HexabitzPlatform/H05R1x-Hardware/README.md

# H05R1x-Hardware

Hexabitz USB-C PD LiPo charger Module Hardware Design.

Design this module using the STM32G0B1CEU6 MCU and BQ25792 + MAX17201G+T ICs. Use the H05R0 module design as a reference.

This design must use two hexagons with a 4-layer PCB stack-up.
