HexabitzPlatform/H05R1x-Hardware/Released/BOM/H05R1_BOM.xlsx

Line # | Name | Description | Designator | Revision ID | Revision State | Revision Status | Quantity | Manufacturer 1 | Manufacturer Part Number 1 | Manufacturer Lifecycle 1 | Supplier 1 | Supplier Part Number 1 | Supplier Unit Price 1 | Supplier Subtotal 1
 | CL10B104KA8NNNC | Ceramic Capacitor, Multilayer, Ceramic, 25V, 10% +Tol, 10% -Tol, X7R, +-15% TC, 100nF, Surface Mount, 0603 inch | C1, C3, C5 |  | Not managed |  | 3
 | CL21X475KAQNNNE | Ceramic Capacitor, Multilayer, Ceramic, 25V, 10% +Tol, 10% -Tol, X6S, +-22% TC, 4.7uF, Surface Mount, 0805 inch | C2 |  | Not managed |  | 1
 | CC0805KKX7R7BB105 | Ceramic Capacitor, Ceramic, 16V, 10% +Tol, 10% -Tol, X7R, 15% TC, 1uF, Surface Mount, 0805 | C4 |  | Not managed |  | 1
 | GRM32ER71H106KA12L | CAP CER 10UF 50V X7R 1210 | C6 | CMP-2000-05261-2 | New From Design | Up to date | 1 | Murata | GRM32ER71H106KA12L | Volume Production | Arrow Electronics | GRM32ER71H106KA12L | 0.294 | 294
 | GRM188R71H104KA93D | Chip Capacitor, 0.1 uF, +/- 10%, 50 V, -55 to 125 degC, 0603 (1608 Metric), RoHS, Tape and Reel | C7 | CMP-2100-03643-1 | Released | Up to date | 1 | Murata | GRM188R71H104KA93D | End of Life | Farnell | 4749383 | 0.01958 | 0.19577
 | GRM155R71H103KA88D | Chip Multilayer Ceramic Capacitors for General Purpose, 0402, 10000pF, X7R, 15%, 10%, 50V | C8, C9 | CMP-2008-04637-5 | New From Design | Up to date | 2 | Murata | GRM155R71H103KA88D | Volume Production | Mouser | 81-GRM155R71H103KA8D | 0.014 | 0.14
 | GRM188R71C473KA01D |  | C10 | CMP-2006-02858-1 | Released | Up to date | 1 | Murata | GRM188R71C473KA01D | End of Life
 | GRM21BZ71E106KE15L | Chip Multilayer Ceramic Capacitors for General Purpose, 0805, 10uF, X7R, 15%, 10%, 25V | C11 | CMP-06035-047417-1 | New From Design | Up to date | 1 | Murata | GRM21BZ71E106KE15L | Volume Production | Mouser | 81-GRM21BZ71E106KE5L | 0.29 | 0.29
 | GRM188R71C105KA12D |  | C12, C15, C17, C18, C20 | CMP-2006-02845-1 | Released | Up to date | 5 | Murata | GRM188R71C105KA12D | End of Life | Farnell | 4749380 | 0.11072 | 1.11
 | GRM21BR60J226ME39L | Chip Multilayer Ceramic Capacitors for General Purpose, 0805, 22uF, X5R, 15%, 20%, 6.3V | C13, C14 | CMP-2007-03385-2 | New From Design | Up to date | 2 | Murata | GRM21BR60J226ME39L | Volume Production | Future Electronics | 1620103 | 0.21 | 0.42
 | GRM21BR60J106KE19L |  | C16 | CMP-2007-03529-1 | Released | Up to date | 1 | Murata | GRM21BR60J106KE19L | End of Life | Farnell | 4740626 | 0.04564 | 0.45636
 | GRM188R71C104KA01D | CAP, Ceramic, 0.1 uF, 10%, 16 V, 0603, RoHS, Tape and Reel | C19 | CMP-2000-05253-1 | Released | Up to date | 1 | Murata | GRM188R71C104KA01D | End of Life | Farnell | 4740617 | 0.01296 | 0.12963
 | GRM188R71E104KA01D |  | C21 | CMP-2006-02868-1 | Released | Up to date | 1 | Murata | GRM188R71E104KA01D | End of Life | Farnell | 4749381 | 0.01296 | 0.12963
 | GRM188R71E105KA12D |  | C22, C23, C24 | CMP-2006-02460-1 | Released | Up to date | 3 | Murata | GRM188R71E105KA12D | End of Life | Farnell | 4749382 | 0.13016 | 1.3
 | CDSOD323-T03SC | A 3V, 350W, bi-directional, standard capacitance, SOD323 pkg TVS Diode | Bourns CDSOD323-T03SC | D1 |  | Not managed |  | 1 | Bourns | CDSOD323-T03SC | Volume Production | DigiKey | CDSOD323-T03SCDKR-ND | 0.69 | 0.69
 | SMBJ24A | TVS DIODE 24V 38.9V SMB | D2 | CMP-07401-000035-1 | New From Design | Up to date | 1 | Bourns | SMBJ24A | Volume Production | Mouser | 652-SMBJ24A | 0.33 | 0.33
 | TPD2E1B06DRLR | TVS DIODE 5.5V 15V 6SOT | D3 | CMP-04985-000003-1 | New From Design | Up to date | 1 | Texas Instruments | TPD2E1B06DRLR | Volume Production | Mouser | 595-TPD2E1B06DRLR | 0.67 | 0.67
 | SS14 | DIODE SCHOTTKY 40V 1A SMA | D4, D5 | CMP-2000-04943-2 | New From Design | Up to date | 2 | onsemi | SS14 | Volume Production | Future Electronics | 2580660 | 0.28 | 0.56
 | 0ZCF0200AF2C | PTC RESET FUSE 24V 2A 2920 | F1 | CMP-16043-000006-1 | New From Design | Up to date | 1 | Bel Fuse | 0ZCF0200AF2C | Volume Production | Mouser | 530-0ZCF0200AF2C | 0.29 | 0.29
 | MMZ1608Y300B | Ferrite Beads 0603 30ohms 1500mA Signal Line AEC-Q200 | FB1 |  | Not managed |  | 1 | TDK | MMZ1608Y300BTA00 | Volume Production | DigiKey | 445-MMZ1608Y300BTA00DKR-ND | 0.1 | 0.1
 | TSW-103-14-G-S | CONN HEADER VERT 3POS 2.54MM | J1 | CMP-02766-001743-1 | New From Design | Up to date | 1 | Samtec | TSW-103-14-G-S | Volume Production | Mouser | 200-TSW10314GS | 0.46 | 0.46
 | USB4110-GF-A | CONN USB 2.0 TYPE-C R/A SMT | J2 | CMP-245163-000002-1 | New From Design | Up to date | 1 | Global Connector Technology | USB4110-GF-A | Volume Production | Mouser | 640-USB4110-GF-A | 1.24 | 1.24
 | B2B-PH-SM4-TB(LF)(SN) | CONN HEADER SMD 2POS 2MM | J3 | CMP-2000-05163-2 | Released | Up to date | 1 | JST | B2B-PH-SM4-TB(LF)(SN) | Volume Production | Mouser | 306-B2BPHSM4TBLFSN | 0.46 | 0.46
 | XAL4020-102MEC | Fixed Inductors 1uH 20% 9.6A 14.60mOhms AEC-Q200 | L1 | CMP-11268-000037-1 | New From Design | Up to date | 1 | Coilcraft | XAL4020-102MEC | Volume Production | Mouser | 994-XAL4020-102MEC | 2.87 | 2.87
 | VLMS1300-GS08 | LED Uni-Color Super Red 639nm 2-Pin Chip 0603(1608Metric) T/R | LED1 |  | Not managed |  | 1 | Vishay | VLMS1300-GS08 | Volume Production | DigiKey | VLMS1300-GS08DKR-ND | 0.21 | 0.21
 | RMCF0603FT4K70 | 4.7kΩ ±1% 0.1W 0603 Thick Film Chip Resistor AEC-Q200 compliant | R1, R2 | CMP-26527-005485-1 | New From Design | Up to date | 2 | Stackpole Electronics | RMCF0603FT4K70 | Volume Production | Mouser | 708-RMCF0603FT4K70 | 0.01 | 0.1
 | Manufacturer Part Number | Res Thick Film 0603 270 Ohm 5% 0.1W(1/10W) ±200ppm/C Pad SMD Automotive T/R | R3 |  | Not managed |  | 1
 | Manufacturer Part Number |  | R4 |  | Not managed |  | 1
 | Manufacturer Part Number | 100mW Thick Film Resistors ±100ppm/℃ ±1% 10kΩ 0603 Chip Resistor - Surface Mount ROHS | R5 |  | Not managed |  | 1
 | RC0603FR-071KL | RES 1K OHM 1% 1/10W 0603 | R6 | CMP-1659-00009-5 | Released | Up to date | 1 | Yageo Group | RC0603FR-071KL | Volume Production
 | RC0603FR-0710KL | RES 10K OHM 1% 1/10W 0603 | R7, R8 | CMP-2100-03664-2 | Released | Up to date | 2 | Yageo Group | RC0603FR-0710KL | Volume Production | Mouser | 603-RC0603FR-0710KL | 0.006 | 0.06
 | RC0603FR-07100RL |  | R9 | CMP-2100-03663-2 | Released | Up to date | 1 | Yageo Group | RC0603FR-07100RL | Volume Production | Farnell | 9238360 | 0.01098 | 0.10979
 | 5015 | PC TEST POINT MINIATURE | TP_U3_SCL, TP_U3_SDA, TP_U5_SCL, TP_U5_SDA | CMP-2000-05183-2 | New From Design | Up to date | 4 | Keystone | 5015 | Volume Production | Farnell | 3858030 | 0.3254 | 1.3
 | STM32G0B1CEU6 | MCU 32-bit ARM Cortex M0+ RISC 512KB Flash 1.8V/2.5V/3.3V 48-Pin UFQFPN EP Tray | U1 |  | Not managed |  | 1 | STMicroelectronics | STM32G0B1CEU6 | Volume Production | Digikey | 497-STM32G0B1CEU6-ND
 | TPD2EUSB30ADRTR | ESD / Surge Solution for High Speed, Low Voltage Interface, 2 Channels, -40 to +85 degC, 3-pin SOT (DRT), Green (RoHS & no Sb/Br) | U2 | CMP-0326-00047-3 | Released | Up to date | 1 | Texas Instruments | TPD2EUSB30ADRTR | Volume Production | Mouser | 595-TPD2EUSB30ADRTR | 0.72 | 0.72
 | BQ25895RTWR | IC NVDC CHARGER I2C 24WQFN | U3 | CMP-04911-000061-1 | New From Design | Up to date | 1 | Texas Instruments | BQ25895RTWR | Volume Production | Mouser | 595-BQ25895RTWR | 3.28 | 3.28
 | AP7333-33SAG-7 | IC REG LINEAR 3.3V 300MA SOT23-3 | U4 | CMP-12756-000020-1 | New From Design | Up to date | 1 | Diodes Inc. | AP7333-33SAG-7 | Volume Production | Mouser | 621-AP7333-33SAG-7 | 0.27 | 0.27
 | STUSB4500QTR | 4.1V~22V USB 2.0 I2C Controllers Interface ICs STUSB45 Controller 24-VFQFN Exposed Pad | U5 | CMP-12113-000003-3 | New From Design | Up to date | 1 | STMicroelectronics | STUSB4500QTR | Volume Production | Arrow Electronics | STUSB4500QTR | 1.79 | 1.79
 | CSTCE8M00G52Z-R0 | Ceramic Resonator 8MHz ±0.5% (Tol) ±0.2% (Stability) 10pF 40Ohm 3-Pin CSMD T/R | X1 |  | Not managed |  | 1
