HexabitzPlatform/H05R1x-Hardware/Design/H05R1.pdf

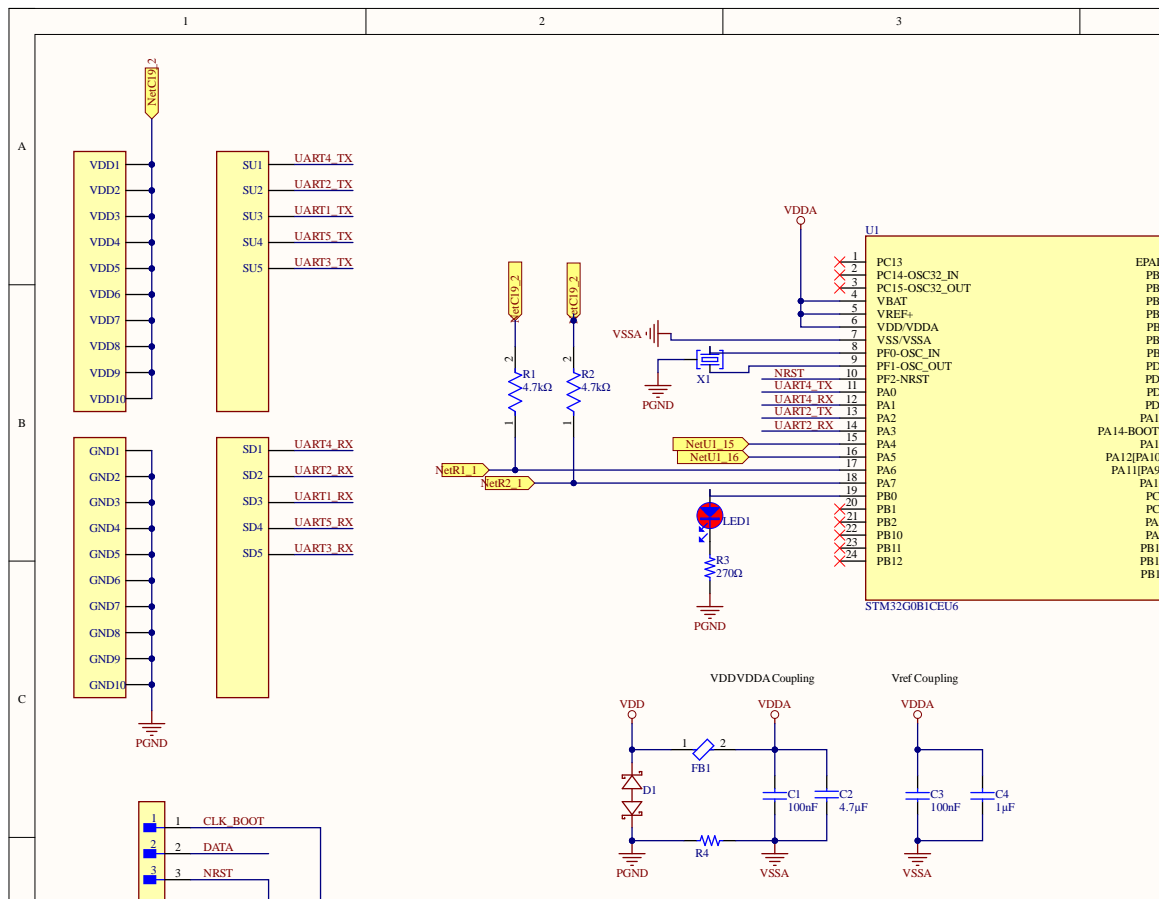
[picture p1: page 1]

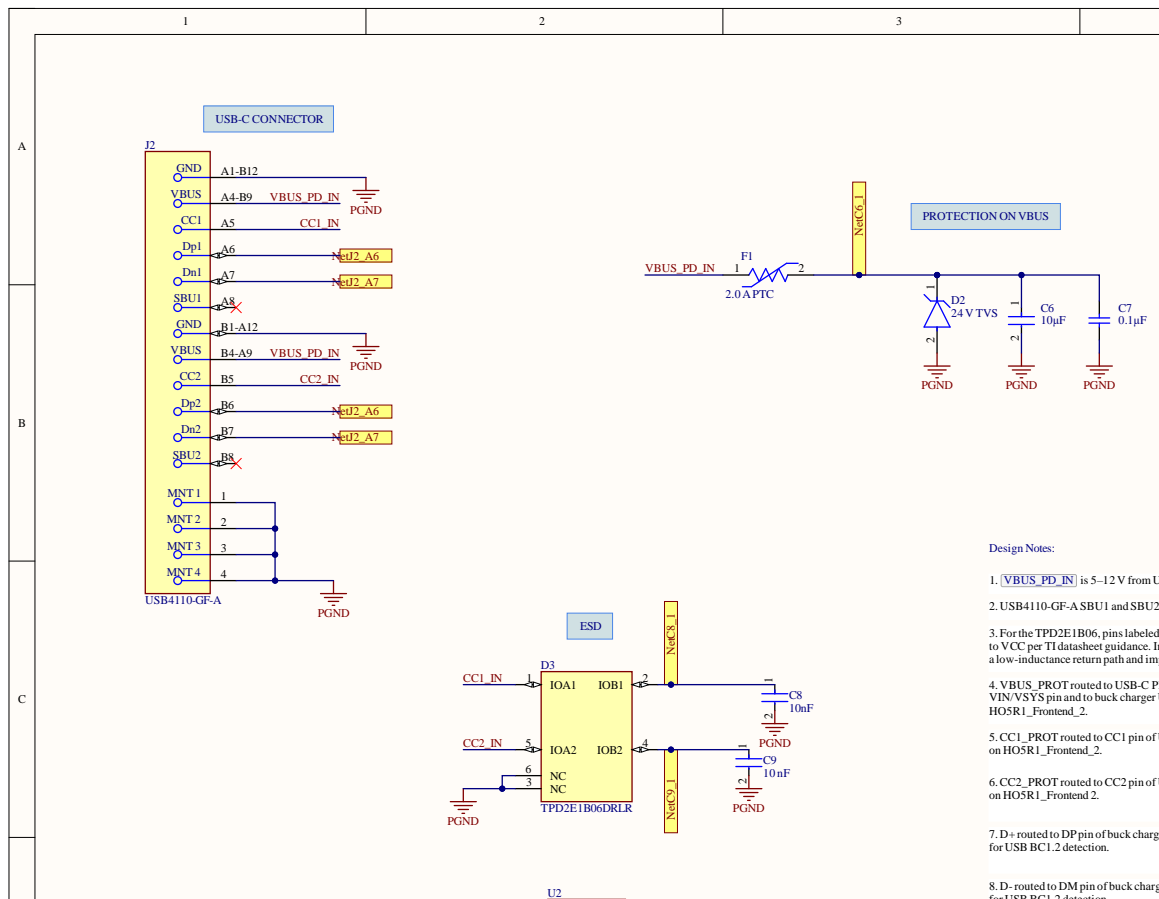
[picture p2: page 2]

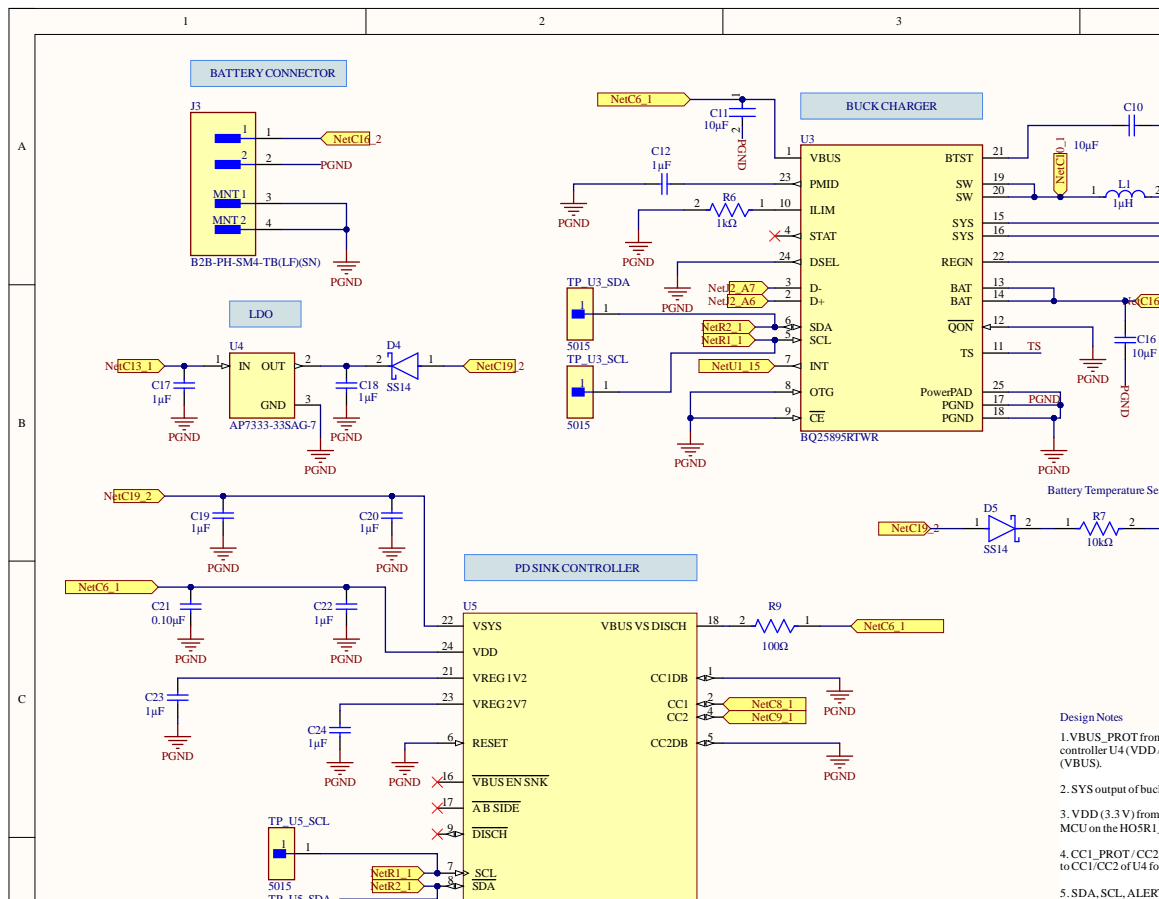
[picture p3: page 3]

PGND
Battery Temperature Sense (TS) Pull-down

Design Notes
1.VBUS_PROT from H05R1_Frontend_1 supplies both the PD
controller U4 (VDD / VBUS_VS_DISCH) and the buck charger U3
(VBUS).

2. SYS output of buck charger U3 powersthe LDO U6.

3. VDD (3.3 V) from LDO U6 powersthe PD controller U4 and the
MCU on the HO5R1_Backend sheet.

4. CC1_PROT /CC2_PROT from H05R1_Frontend_1 connect directly
toCC1/CC2 of U4 for USB-C role detection and PD negotiation.

5. SDA, SCL, ALERT (U4), andCHG_INT (U3) are routed to the

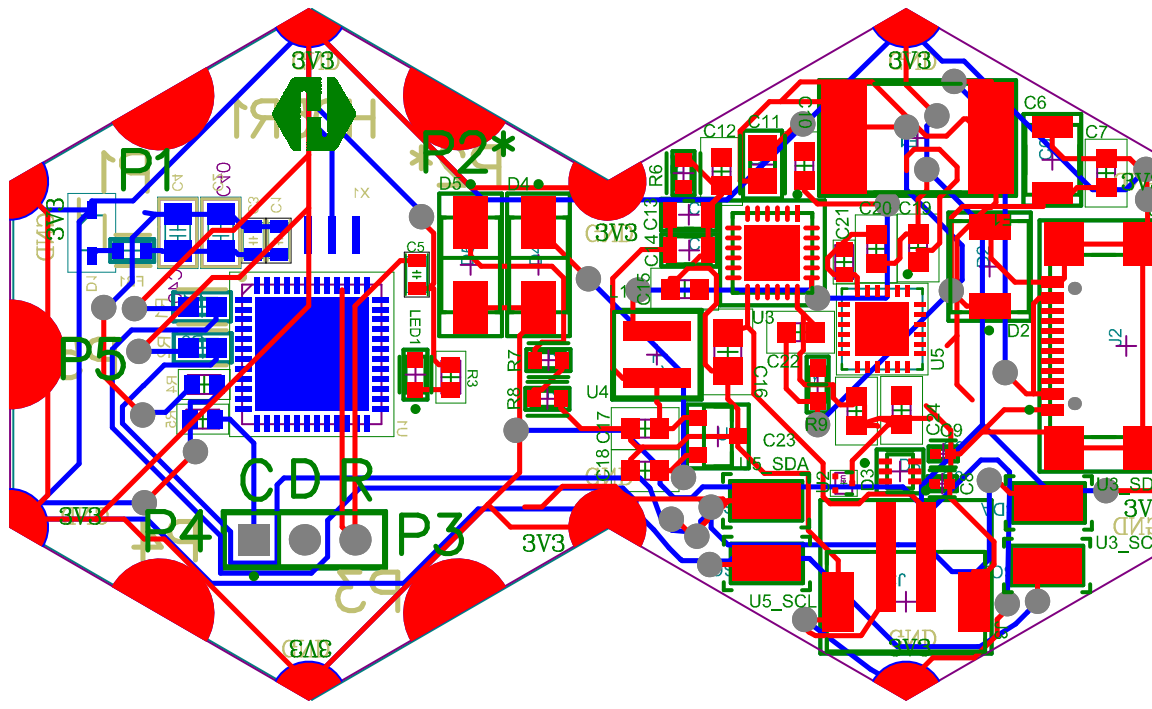
[picture p4: page 4]

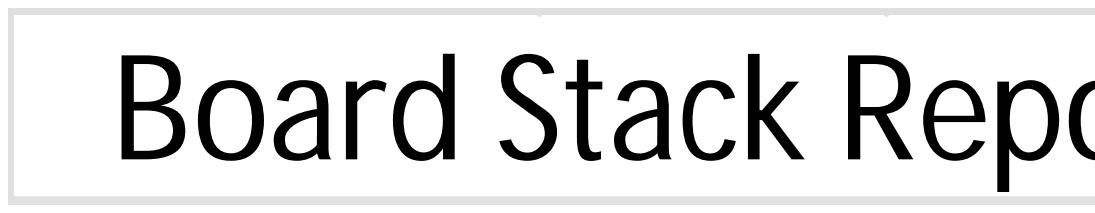
[picture p5: page 5]
