HexabitzPlatform/H05R1x-Hardware/Documentation/H05R1_Schematics.pdf

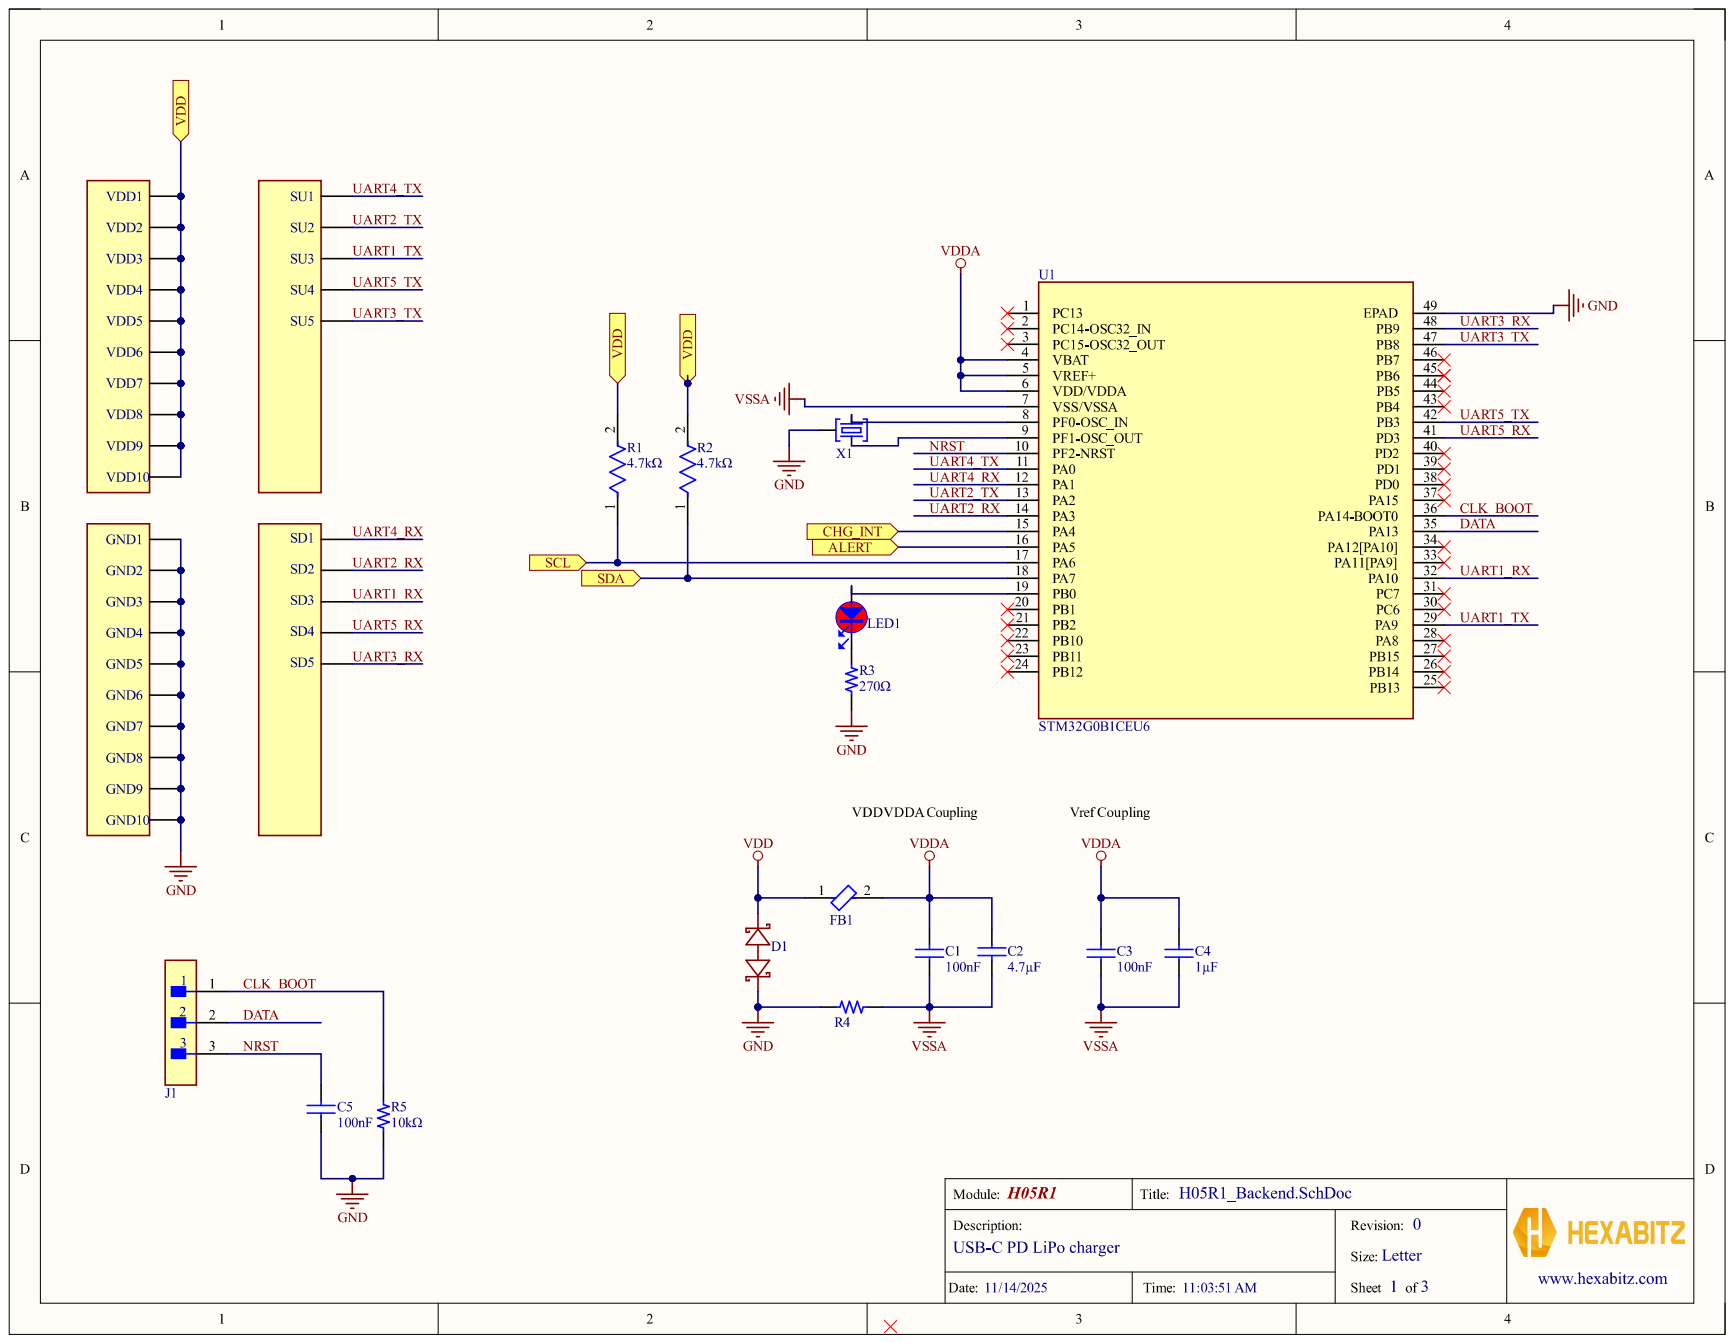
[picture p6: page 1]

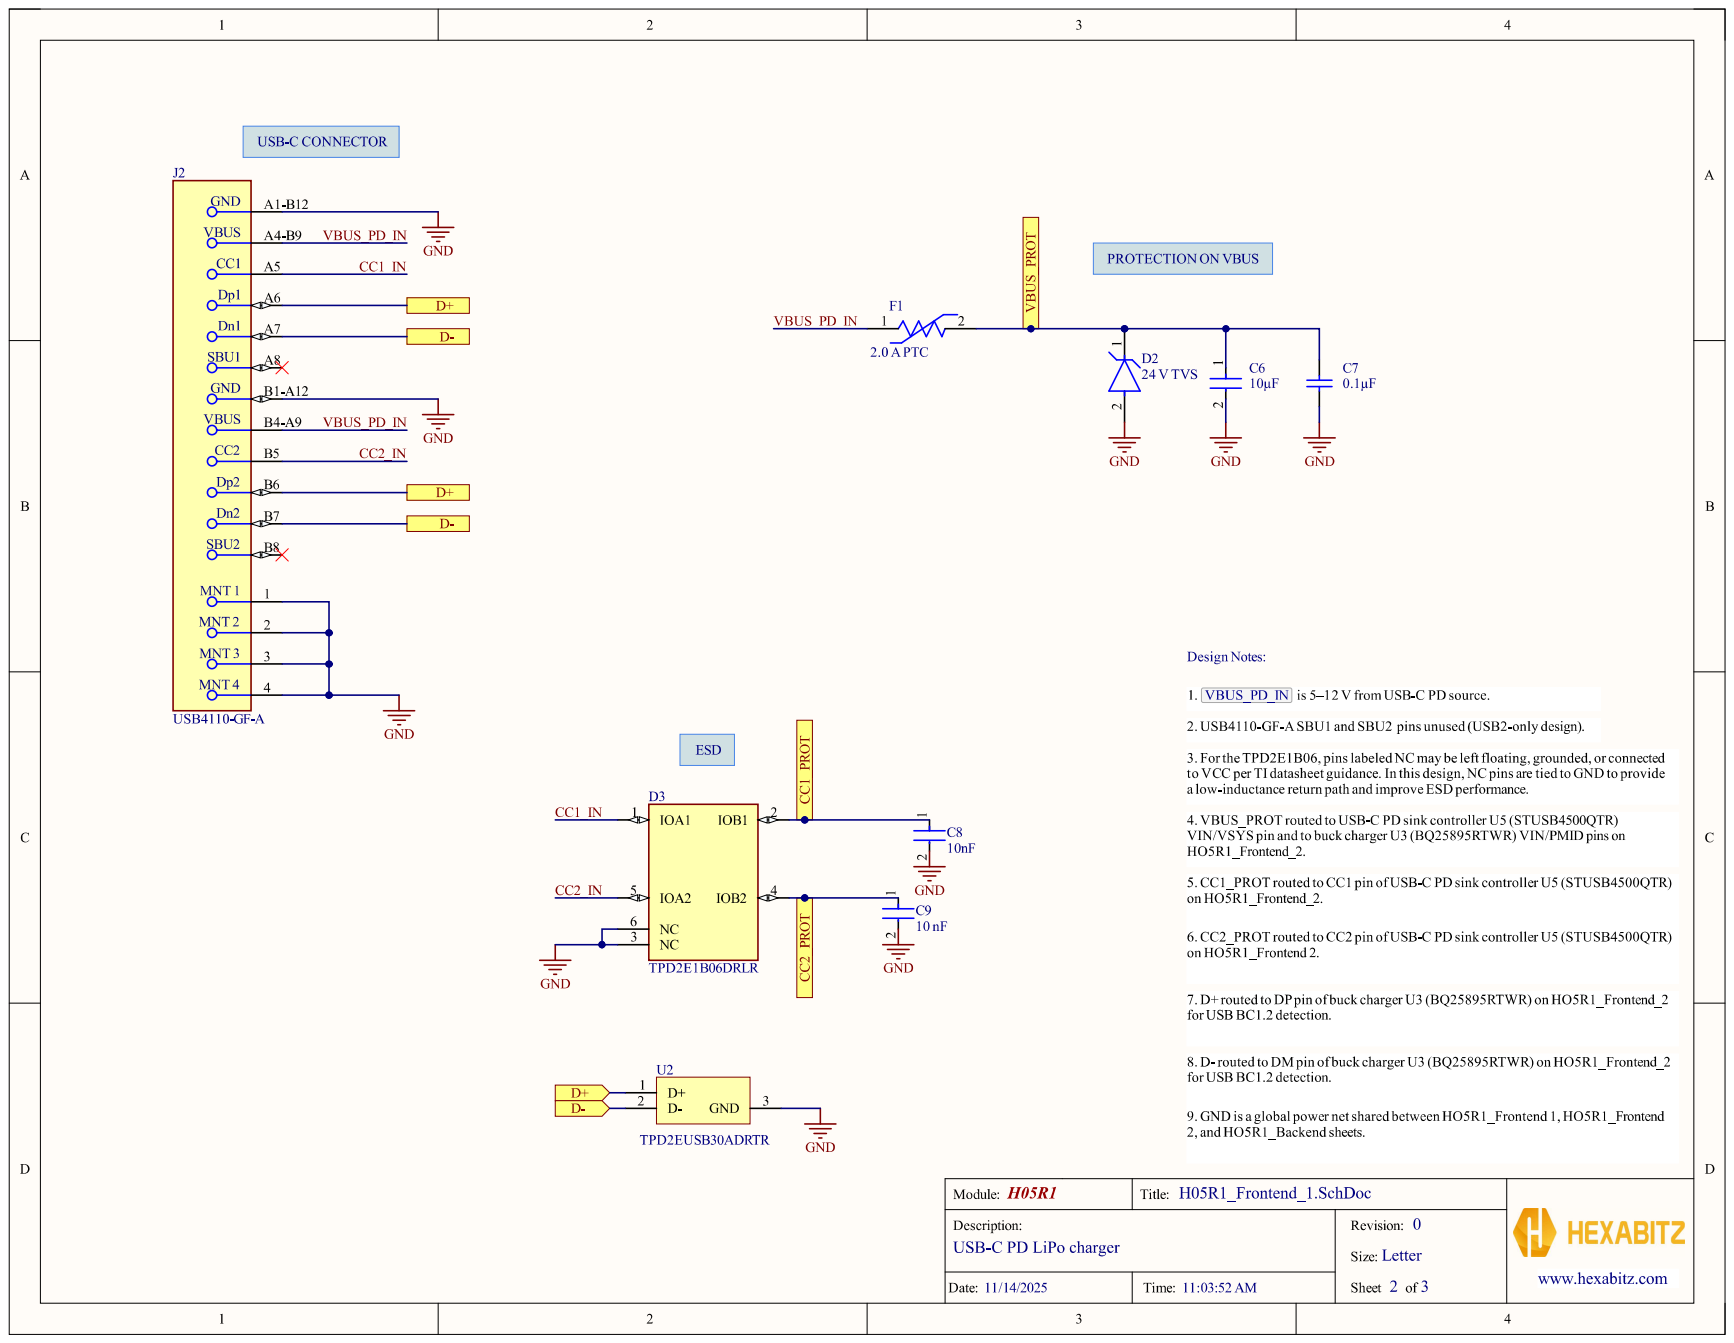
[picture p7: page 2]

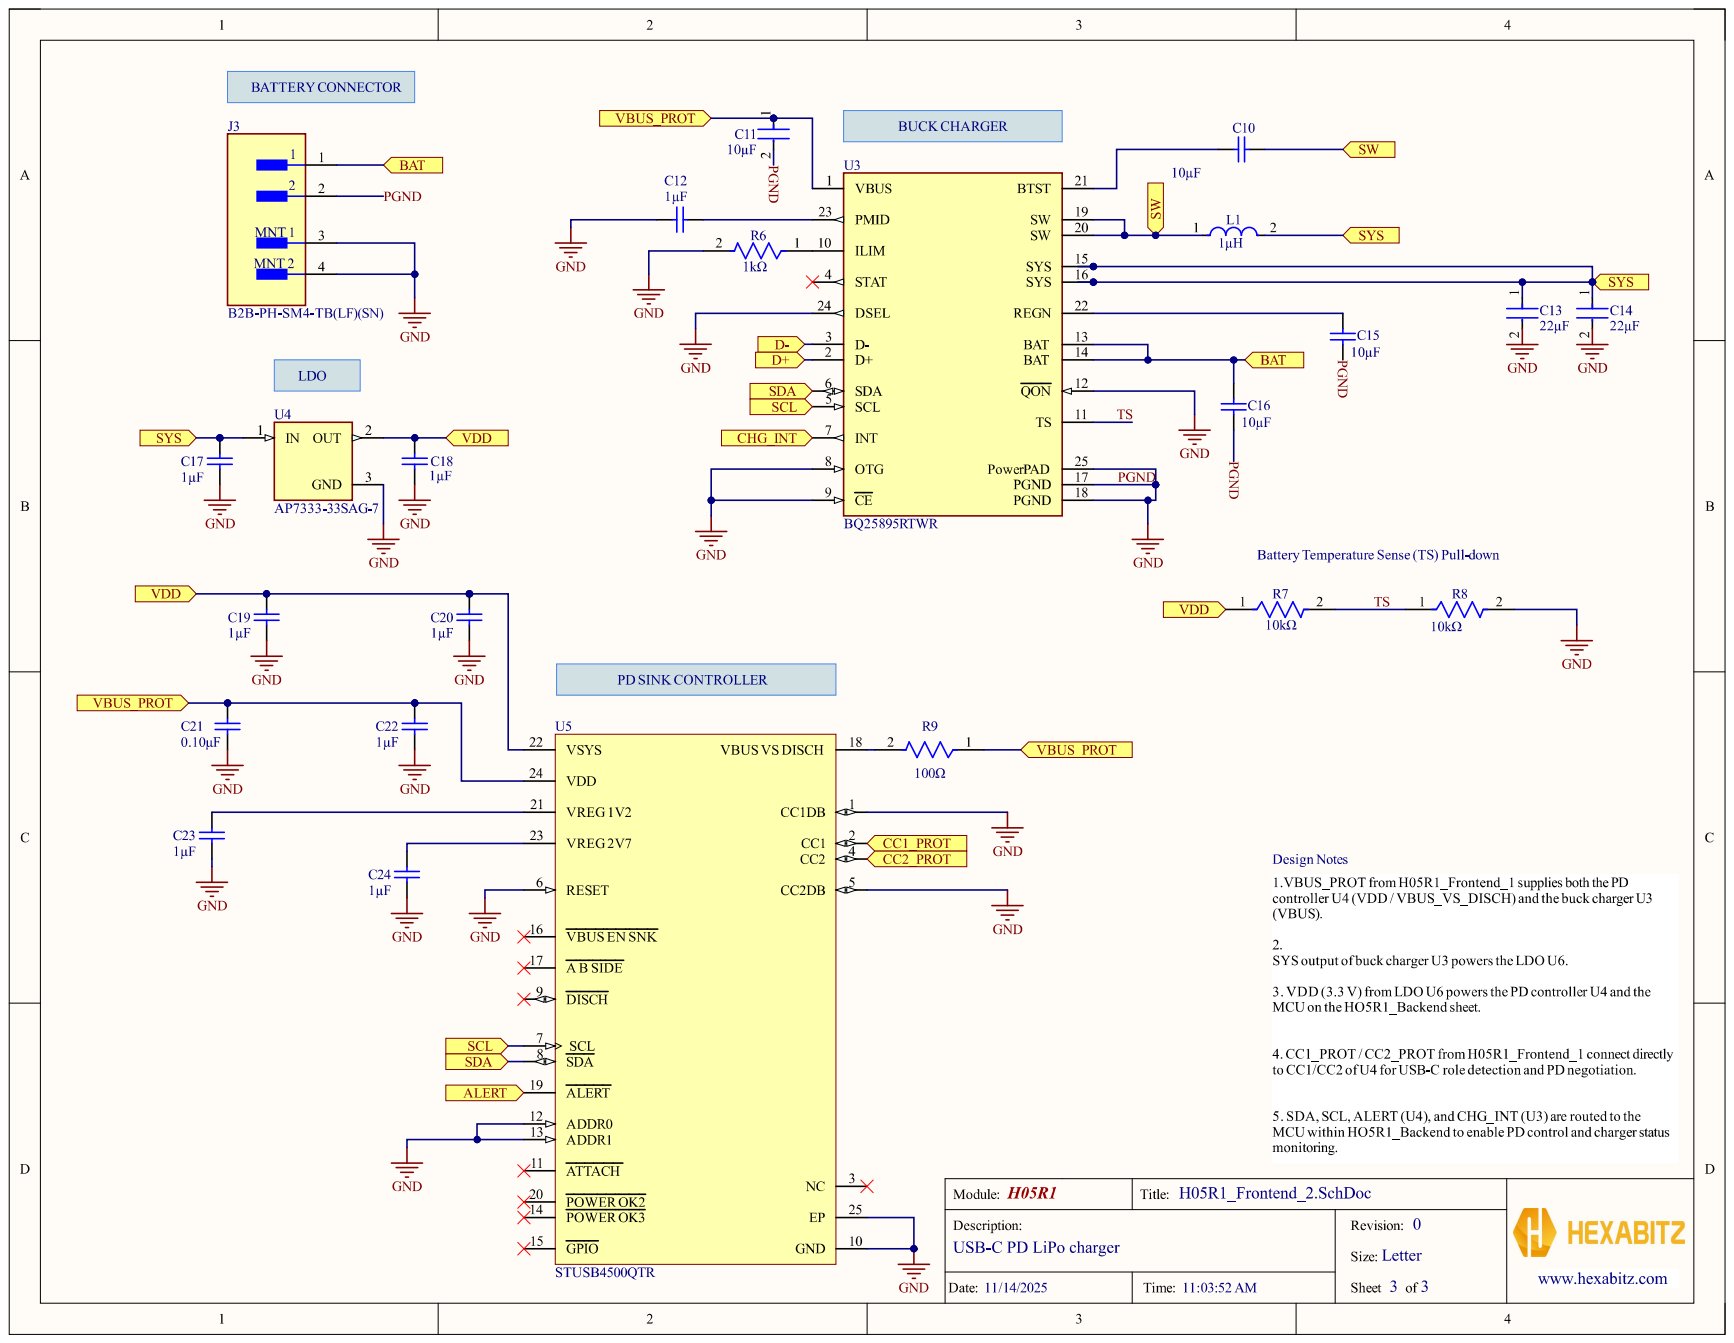
[picture p8: page 3]
