HexabitzPlatform/H05R1x-Hardware/Documentation/H05R1_PCB_Rev_3.pdf

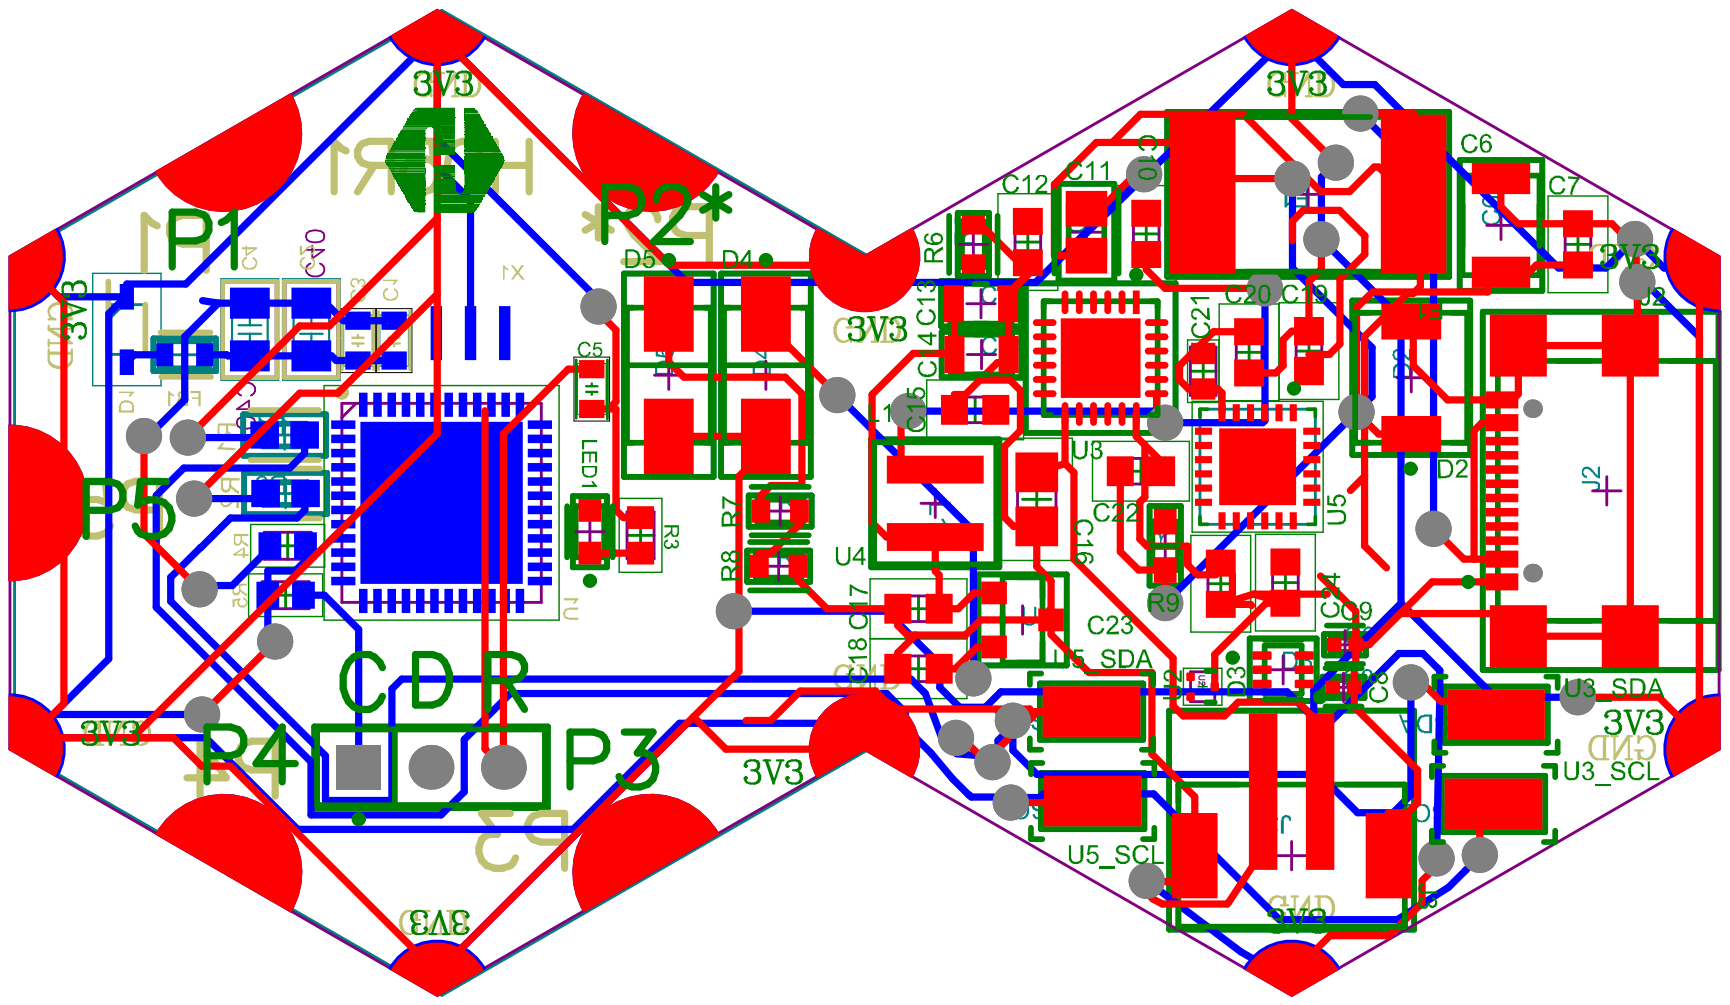
[picture p9: page 1]
