HexabitzPlatform/H05R1x-Hardware/(list of files, drawings)

Other design files:
Design/H05R1.PrjPcb
Design/H05R1_Backend.SchDoc
Design/H05R1_Frontend_1.SchDoc
Design/H05R1_Frontend_2.SchDoc
H05R1_Backend.SchDoc
H05R1_Frontend_1.SchDoc
H05R1_Frontend_2.SchDoc
