HexabitzPlatform/H05R1x-Hardware/(commit log)

2025-10-16 The Altium template has been added.
    [H01R0.PcbDoc, H01R0.PrjPcb, H01R0_Backend.SchDoc, H01R0_Frontend 1.SchDoc, H01R0_Frontend 2.SchDoc, H1DR1x-T.xlsx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]
2025-11-14 Add files via upload
    H05R1 Rev 1 Frontend and Backend Schematics.
2025-11-14 Add files via upload
    H05R1 Backend Schematic Rev 1.
    [H05R1_Backend.SchDoc]
2025-11-14 Add files via upload
    H05R1 Frontend Schematic 1 Rev 1.
    [H05R1_Frontend_1.SchDoc]
2025-11-14 Add files via upload
    H05R1 Frontend Schematic 2 Rev 1.
    [H05R1_Frontend_2.SchDoc]
2025-11-14 Add files via upload
    H05R1 BOM Rev 1.
2025-11-26 Delete Design directory
    Deleted to upload my recent design documents.
    [H01R0.PcbDoc, H01R0.PrjPcb, H01R0_Backend.SchDoc, H01R0_Frontend 1.SchDoc, H01R0_Frontend 2.SchDoc, H05R1_Backend.SchDoc, H05R1_Frontend_1.SchDoc, H05R1_Frontend_2.SchDoc]
2025-12-01 Update and rename H05R1.PrjPcb to Design/H05R1.PrjPcb
    [H05R1.PrjPcb]
2025-12-01 Add files via upload
    Revision 3 of the project for PCB layout to include routing, Update module PN, designators placement, as well as a few other minor corrections.
    [H05R1.PrjPcb]
2025-12-01 Create Build of Materials
2025-12-01 Add files via upload
    Manufacturing File 1: Build of Materials
    [H05R1_BOM.xlsx]
2025-12-01 Add files via upload
    Manfacturing Documents: Drill Files
2025-12-01 Rename Released/H05R1_3D.step to Released/3D Model/H05R1_3D.step
    [H05R1_3D.step]
2025-12-01 Add files via upload
    Final Project Schematics
2025-12-01 Rename Documentation/H05R1_Schematics.pdf to Documentation/FInal Schematics/H05R1_Schematics.pdf
2025-12-01 Add files via upload
    Final Project File 12/1/2025
    [H05R1.PrjPcb]
